DptHiggs/Robotic3DPrinting/Pictures/Bed Scan.jpg

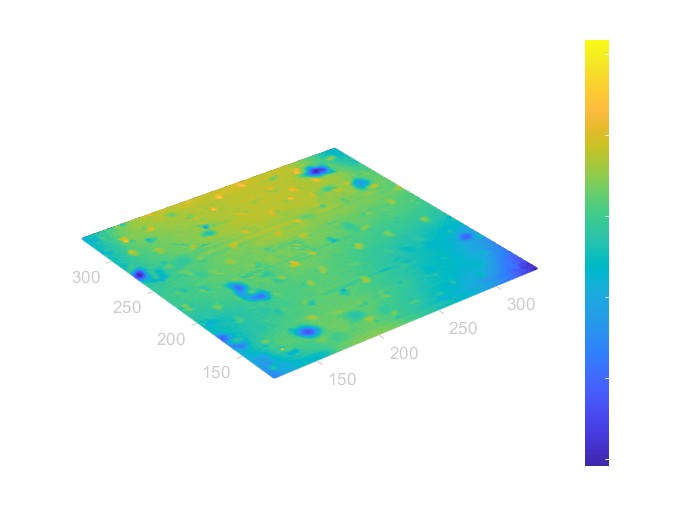
Pictures/Bed Scan.jpg
