DptHiggs/Robotic3DPrinting/Pictures/20240214_153519~2.jpg

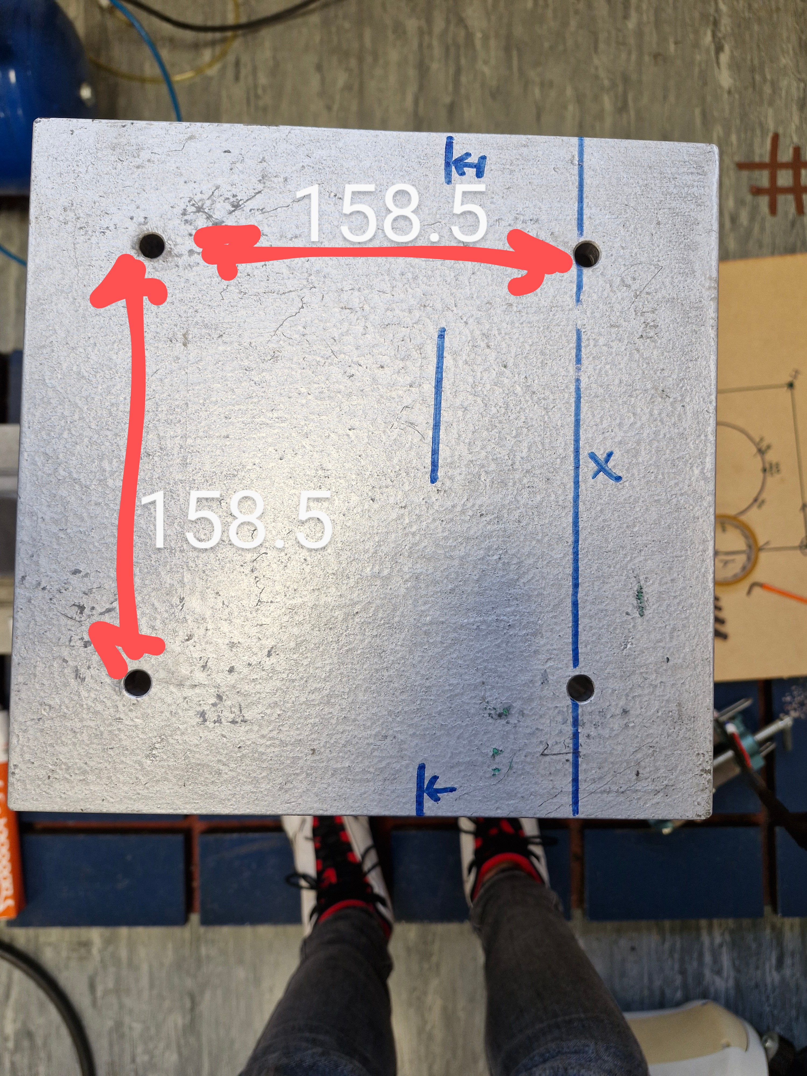
Pictures/20240214_153519~2.jpg
