DptHiggs/Robotic3DPrinting/Pictures/20240214_153514~2.jpg

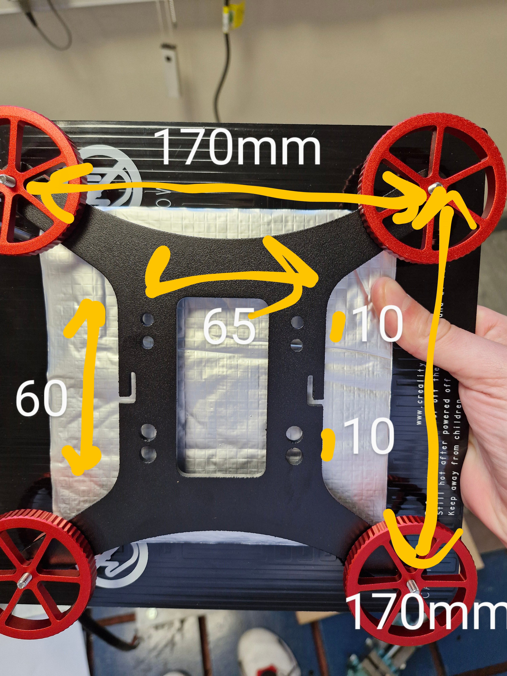
Pictures/20240214_153514~2.jpg
