DptHiggs/Robotic3DPrinting/Pictures/20240214_154942~2.jpg

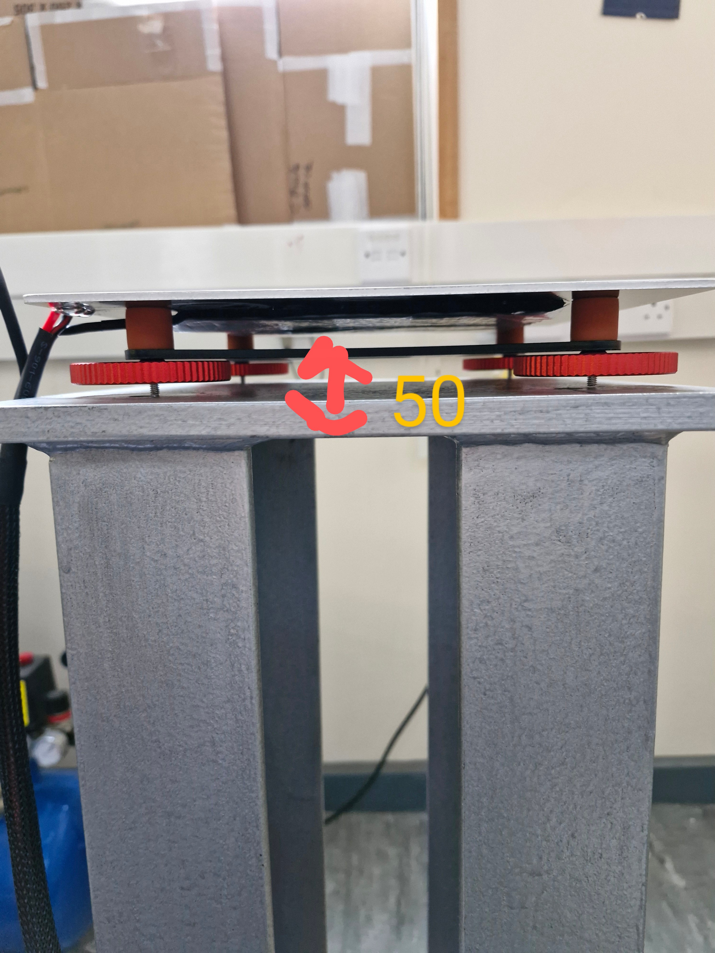
Pictures/20240214_154942~2.jpg
