DptHiggs/Robotic3DPrinting/Pictures/Bed Probe.jpg

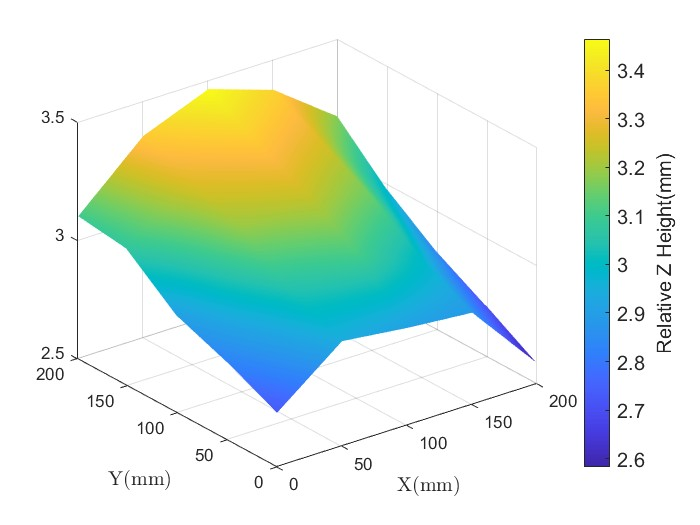
Pictures/Bed Probe.jpg
