DptHiggs/Robotic3DPrinting/Pictures/Screenshot 2024-04-11 134530.png

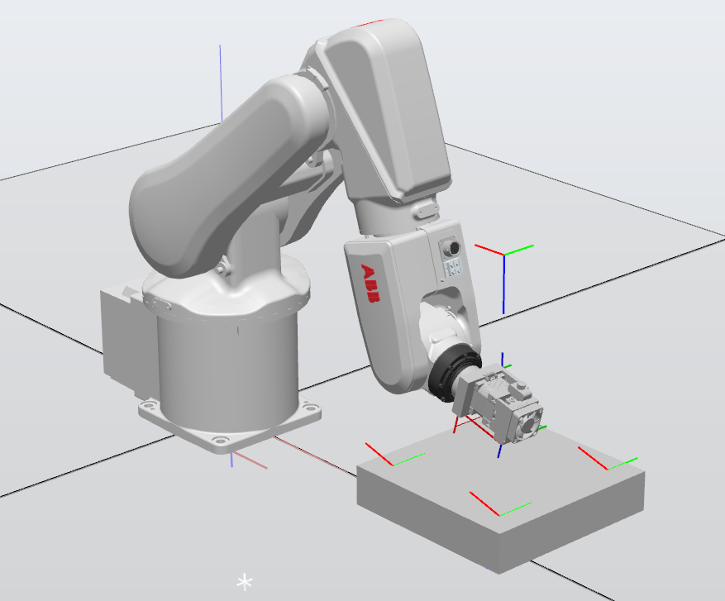
Pictures/Screenshot 2024-04-11 134530.png
