DptHiggs/Robotic3DPrinting/Pictures/Screenshot 2024-04-11 134553.png

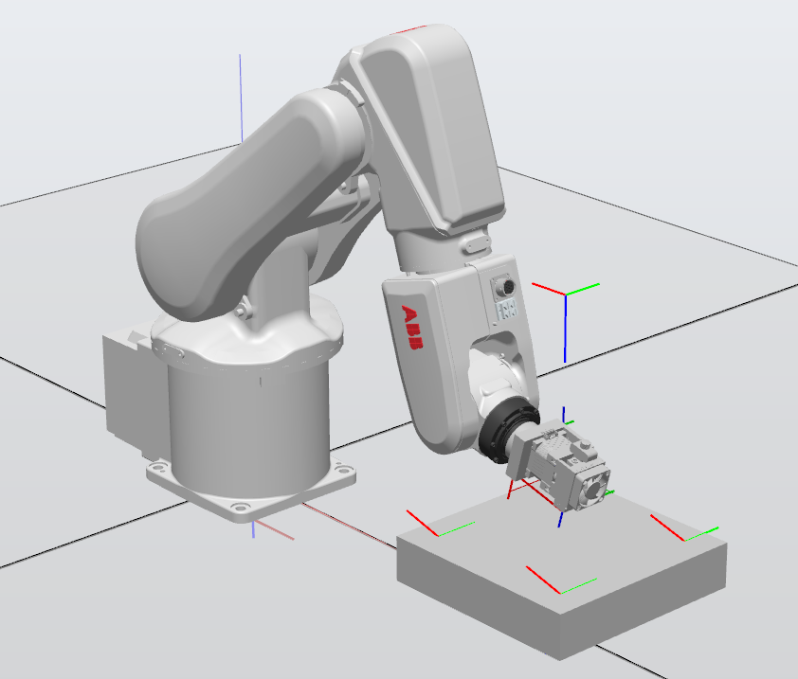
Pictures/Screenshot 2024-04-11 134553.png
