DptHiggs/Robotic3DPrinting/Pictures/Screenshot 2024-04-11 134730.png

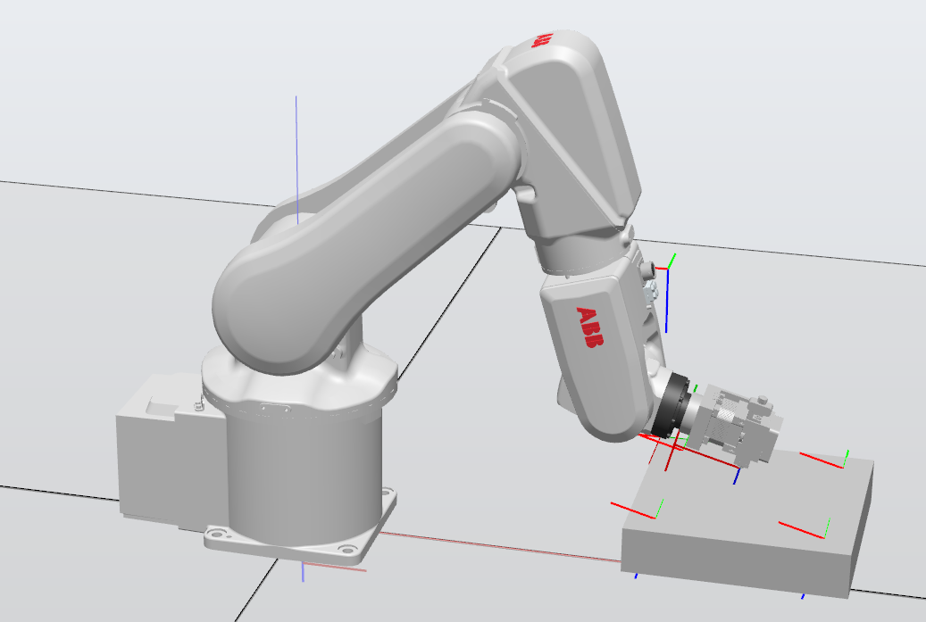
Pictures/Screenshot 2024-04-11 134730.png
