DptHiggs/Robotic3DPrinting/Pictures/tempPlot.png

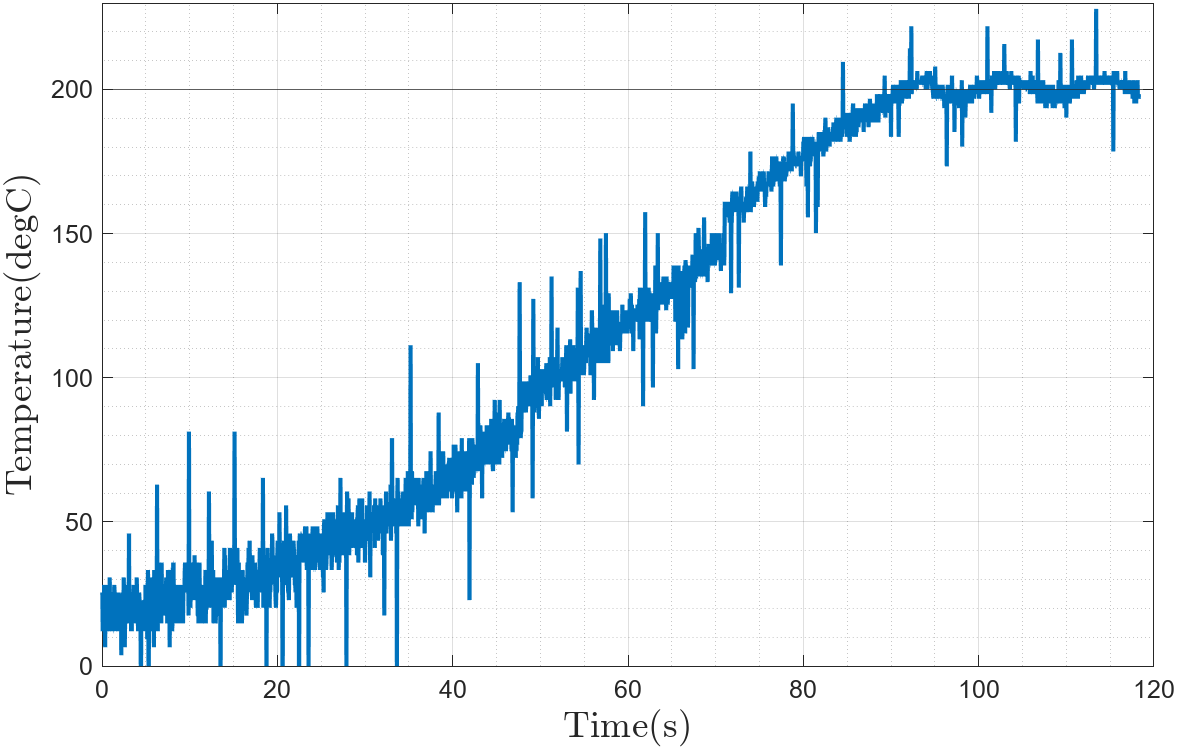
Pictures/tempPlot.png
