DptHiggs/Robotic3DPrinting/Pictures/tempPlotDenoised.png

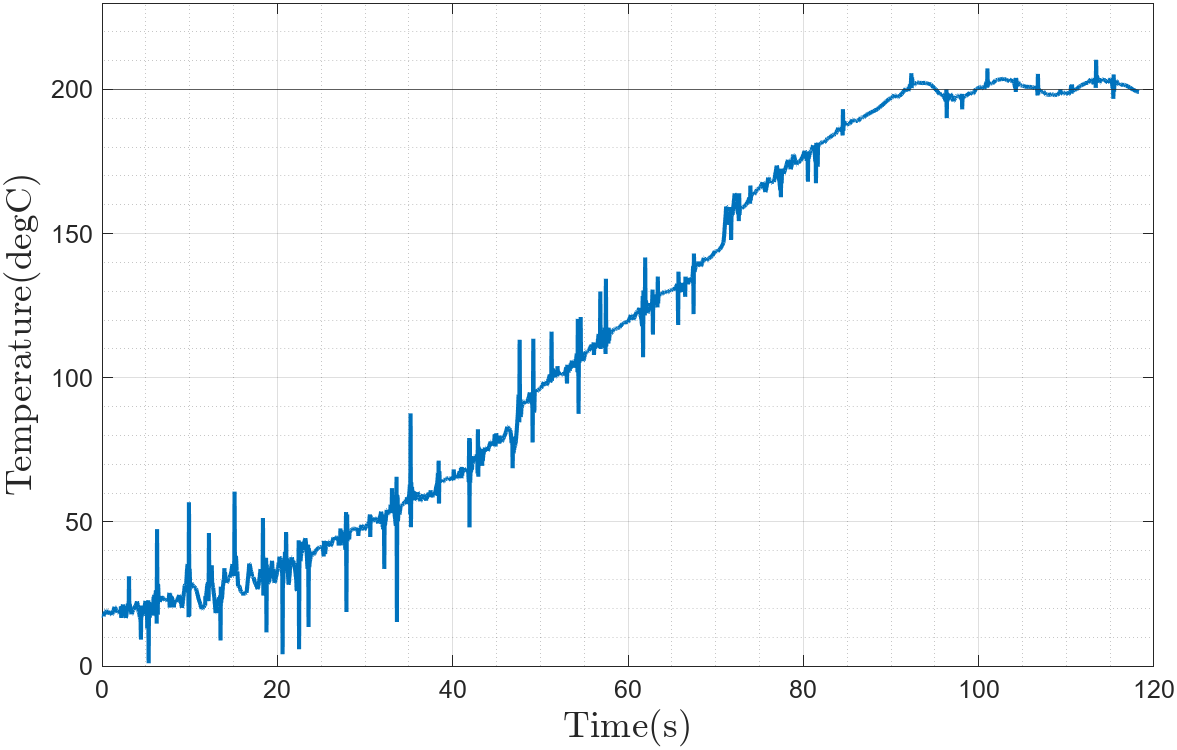
Pictures/tempPlotDenoised.png
