DptHiggs/Robotic3DPrinting/Pictures/untitled.png

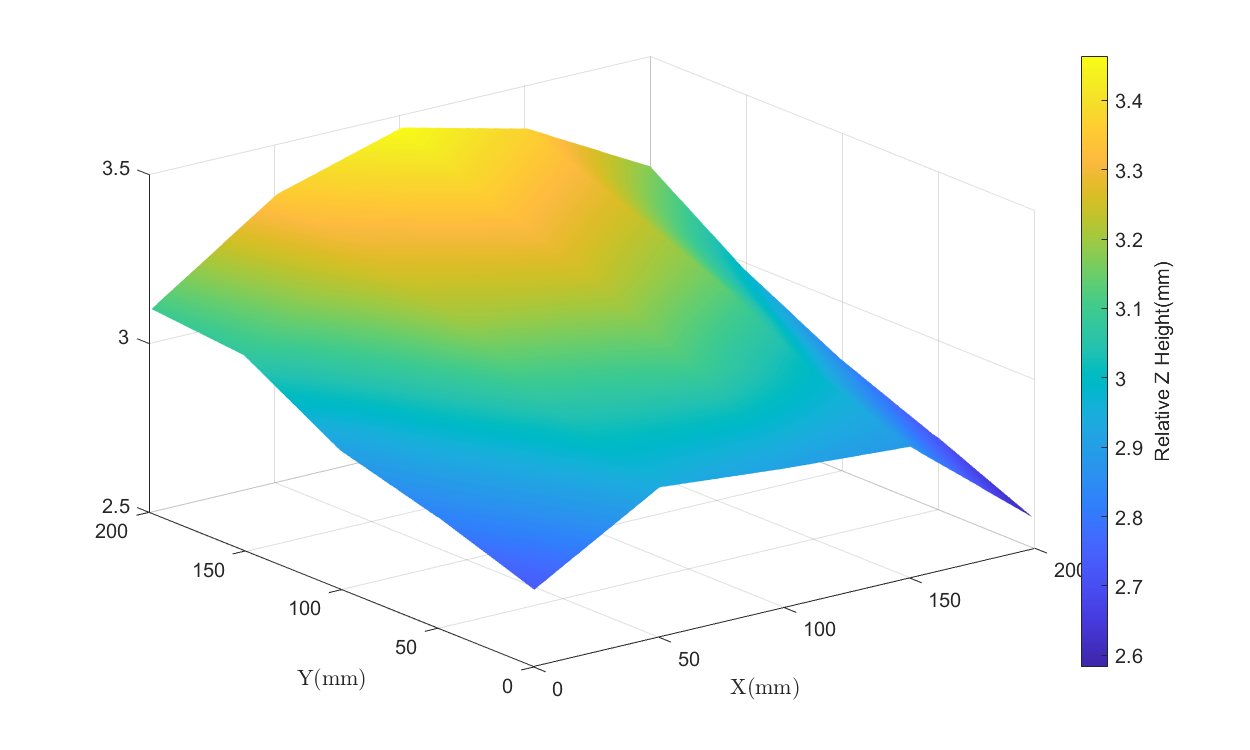
Pictures/untitled.png
